tungkaG/micromouse/Bill_of_Materials.xls

MICRO MOUSE
Mouser-Nr. | Herst.- Nr. | Hersteller | Kunden-Teilenr | Beschreibung | RoHS | Lebenszyklus | Stückzahl | Preis (EUR) | Gesamtpreis: (EUR)
579-DSPIC364MC804IML | DSPIC33FJ64MC804-I/ML | Microchip |  | Digitale Signalprozessoren und Controller - DSP, DSC 16B DSC 44LD64KB | RoHS-konform |  | 1 | 6,65 € | 6,65 €
852-GP2Y0A51SK0F | GP2Y0A51SK0F | Sharp Microelectronics |  | Entfernungssensor-Module - umschlossen | RoHS-konform |  | 3 | 5,78 € | 17,34 €
815-ABM8-20-B2-T | ABM8-20.000MHZ-B2-T | ABRACON |  | Quarze Xtal 3225 4-SMD 20MHz Tol A+/-20ppm Stab A+/-50ppm -20AC ~ 70AC 18pF 50 Ohms | RoHS-konform |  | 1 | 0,387 € | 0,39 €
757-TB6612FNGC8EL | TB6612FNG,C,8,EL | Toshiba |  | Motor / Bewegung / Zündungscontroller und Treiber Brush Motor Driver IC | RoHS-konform |  | 2 | 1,64 € | 3,28 €
520-HCU737-20X | ECS-73-20-4X | ECS |  | Quarze 7.3728MHz 20pF | RoHS-konform |  | 2 | 0,513 € | 1,03 €
653-B3F-1020 | B3F-1020 | Omron |  | Sensorschalter 6X6 Flat 5mm Btn Force 100g w/o Grd | RoHS-konform |  | 1 | 0,261 € | 0,26 €
859-LTST-C150KRKT | LTST-C150KRKT | LITEON |  | Einfarbige LEDs leds Red Clear 631nm | RoHS-konform |  | 1 | 0,234 € | 0,23 €
855-M20-8900605R | M20-8900605R | Harwin |  | Sockel & Kabelgehäuse 6 WAY SIL HORIZ SMT HDR T&R (600) | RoHS-konform |  | 1 | 1,33 € | 1,33 €
926-LM2937IMP5.0NOPB | LM2937IMP-5.0/NOPB | Texas Instruments |  | LDO Spannungs-Regulator 500 MA LDO REG A 926-LM2937IMPX50NOPB | RoHS-konform |  | 1 | 2,09 € | 2,09 €
