tungkaG/micromouse/Mouser Parts/0.1µF/C0805J104K1RACAUTO/3D/C0805J104K1RACAUTO.stp

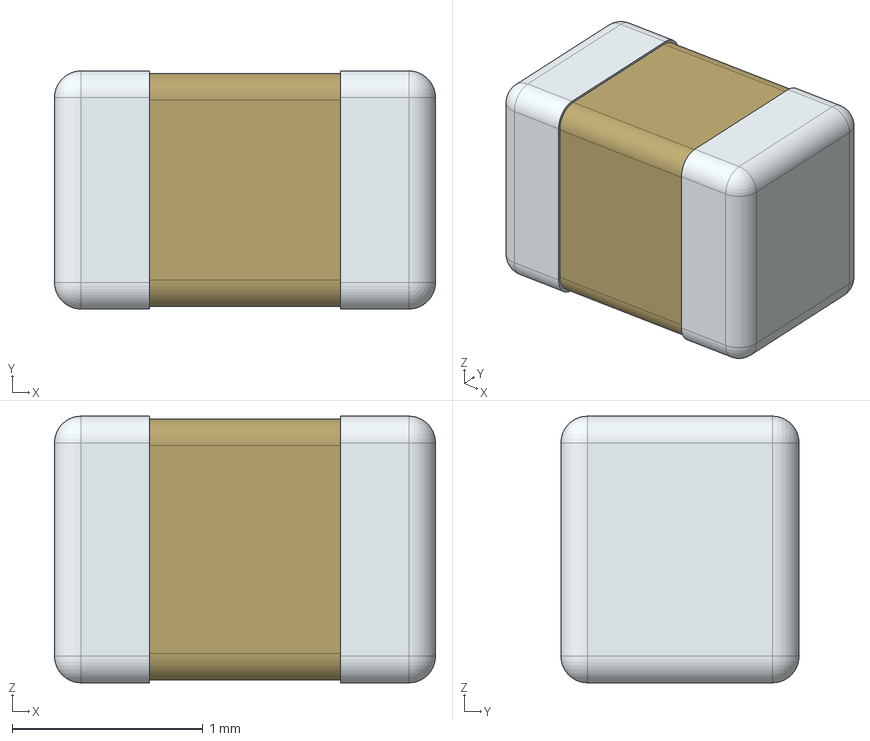
[picture p1: CAD file, 2025-08-03]
Mouser Parts/0.1µF/C0805J104K1RACAUTO/3D/C0805J104K1RACAUTO.stp
2.00 x 1.25 x 1.40 mm
