tungkaG/micromouse/Mouser Parts/10k Resistor/RNCE0805BTE10K0/3D/RNCE0805BTE10K0.stp

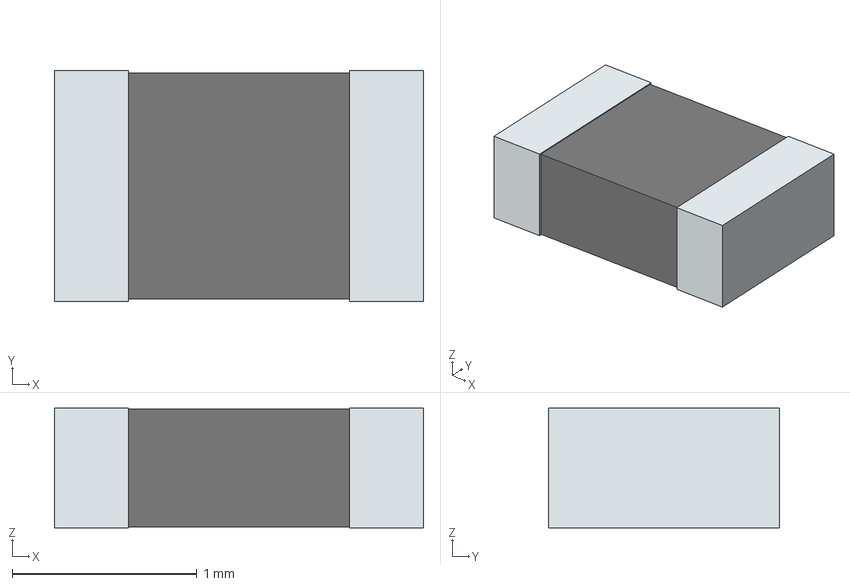
[picture p2: CAD file, 2025-08-04]
Mouser Parts/10k Resistor/RNCE0805BTE10K0/3D/RNCE0805BTE10K0.stp
2.00 x 1.25 x 0.65 mm
term1
term2
