tungkaG/micromouse/Mouser Parts/10µF Capacitor/0805YC106KAT2A/3D/0805YC106KAT2A.stp

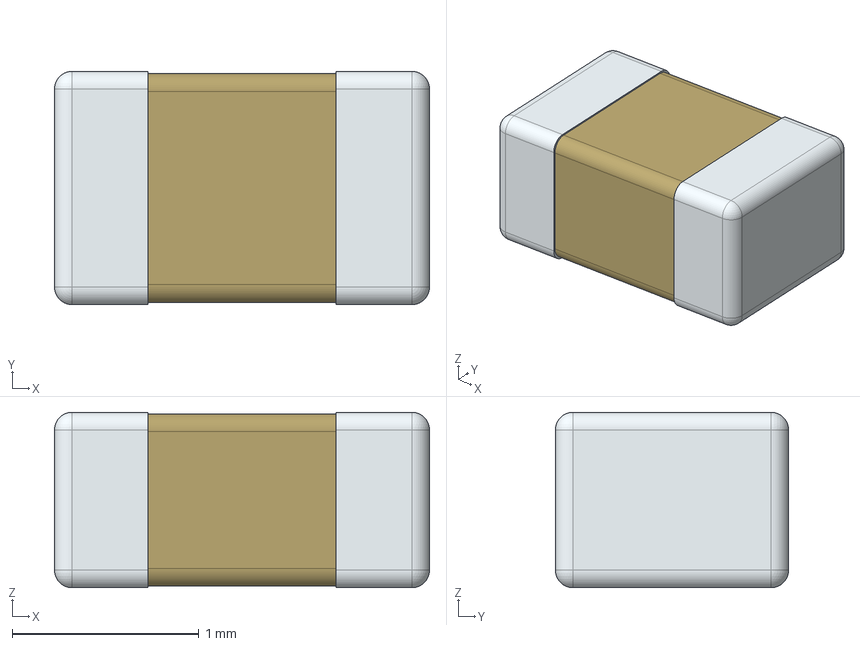
[picture p3: CAD file, 2025-08-03]
Mouser Parts/10µF Capacitor/0805YC106KAT2A/3D/0805YC106KAT2A.stp
2.01 x 1.25 x 0.94 mm
