tungkaG/micromouse/Mouser Parts/4.7k Resistor/ERA-6ARW472V/3D/ERA-6ARW472V.stp

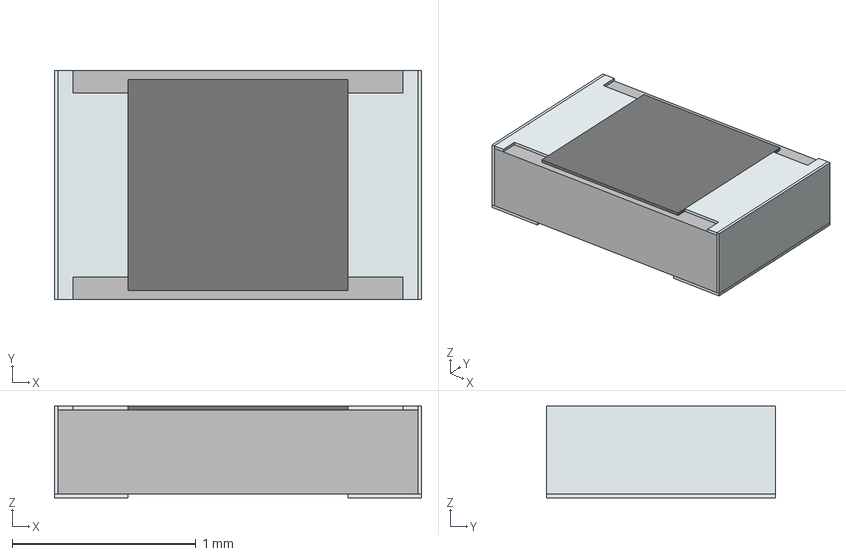
[picture p4: CAD file, 2025-08-03]
Mouser Parts/4.7k Resistor/ERA-6ARW472V/3D/ERA-6ARW472V.stp
2.00 x 1.25 x 0.5 mm
solidBody
solidTop
solidTerminal1
solidTerminal2
solidTerminal3
