tungkaG/micromouse/Mouser Parts/4.7µF/MBAST21GBC7475KTCA01/3D/MBAST21GBC7475KTCA01.stp

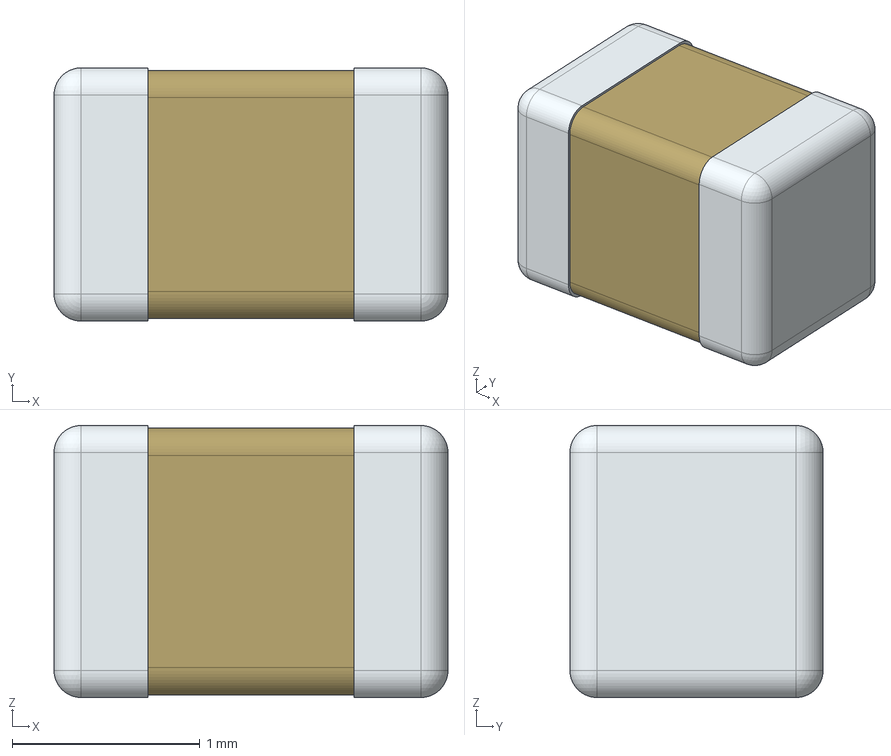
[picture p5: CAD file, 2025-08-04]
Mouser Parts/4.7µF/MBAST21GBC7475KTCA01/3D/MBAST21GBC7475KTCA01.stp
2.10 x 1.35 x 1.45 mm
