tungkaG/micromouse/Mouser Parts/Bluetooth/RN4871-I_RM130/3D/RN4871-I_RM130.stp

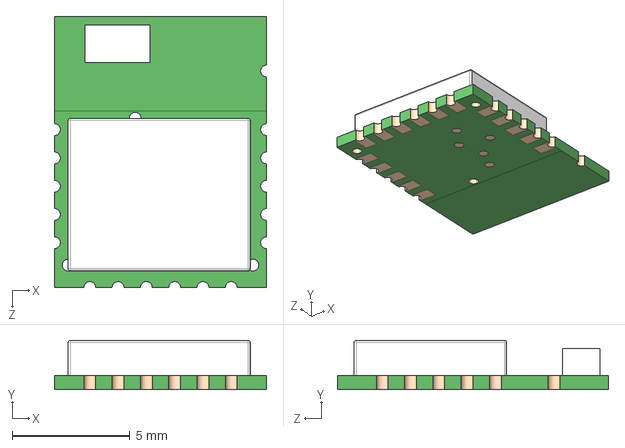
[picture p6: CAD file, 2025-07-26]
Mouser Parts/Bluetooth/RN4871-I_RM130/3D/RN4871-I_RM130.stp
9.00 x 2.10 x 11.5 mm
