tungkaG/micromouse/Mouser Parts/Chip/LIB_dsPIC33FJ64MC804-I_ML/dsPIC33FJ64MC804-I_ML/3D/dsPIC33FJ64MC804-I_ML.stp

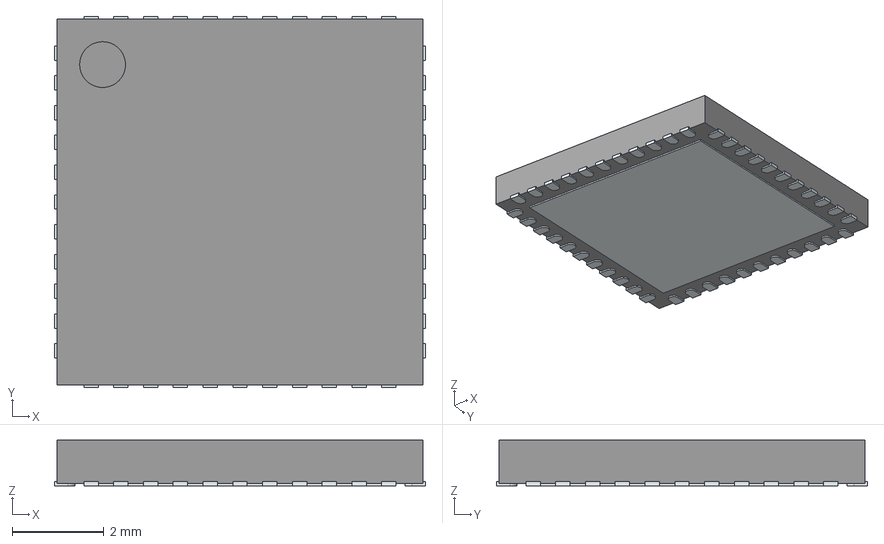
[picture p7: CAD file, 2025-07-16]
Mouser Parts/Chip/LIB_dsPIC33FJ64MC804-I_ML/dsPIC33FJ64MC804-I_ML/3D/dsPIC33FJ64MC804-I_ML.stp
8.10 x 8.10 x 1.00 mm
ThermalPin
PinsArrayLR
PinsArrayTB
