tungkaG/micromouse/Mouser Parts/Diode/1N4148WS-HG3-08/3D/1N4148WS-HG3-08.stp

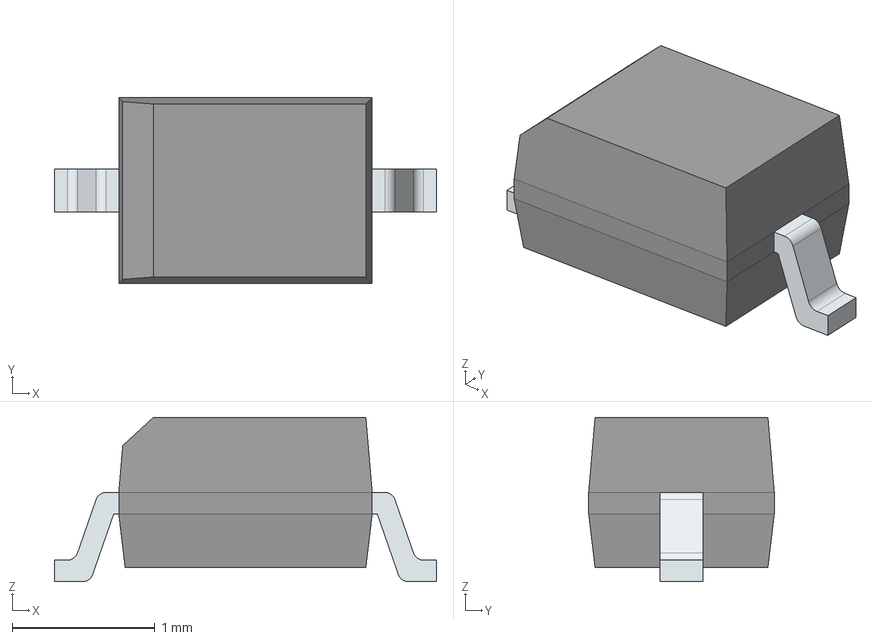
[picture p8: CAD file, 2025-08-03]
Mouser Parts/Diode/1N4148WS-HG3-08/3D/1N4148WS-HG3-08.stp
2.67 x 1.30 x 1.15 mm
FilletPinL
FilletPinR
