tungkaG/micromouse/Mouser Parts/H-Bridge/TB6612FNG,C,8,EL/3D/TB6612FNG,C,8,EL.stp

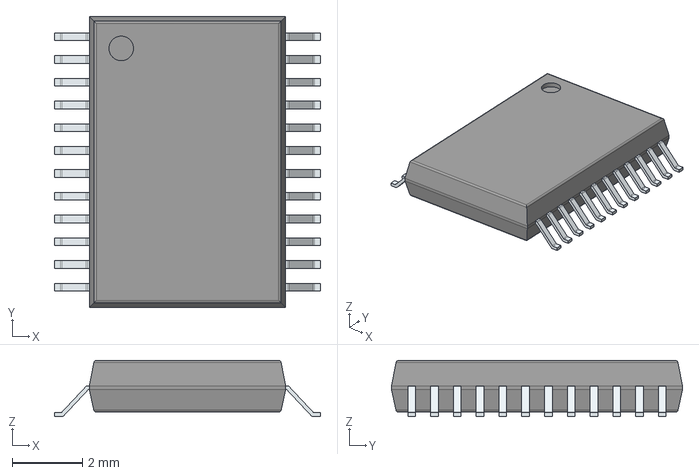
[picture p9: CAD file, 2025-07-20]
Mouser Parts/H-Bridge/TB6612FNG,C,8,EL/3D/TB6612FNG,C,8,EL.stp
7.60 x 8.30 x 1.60 mm
PinsArrayLR
