tungkaG/micromouse/Mouser Parts/Linear Regulator 3.3V/UA78M33CDCYG3/3D/UA78M33CDCYG3.stp

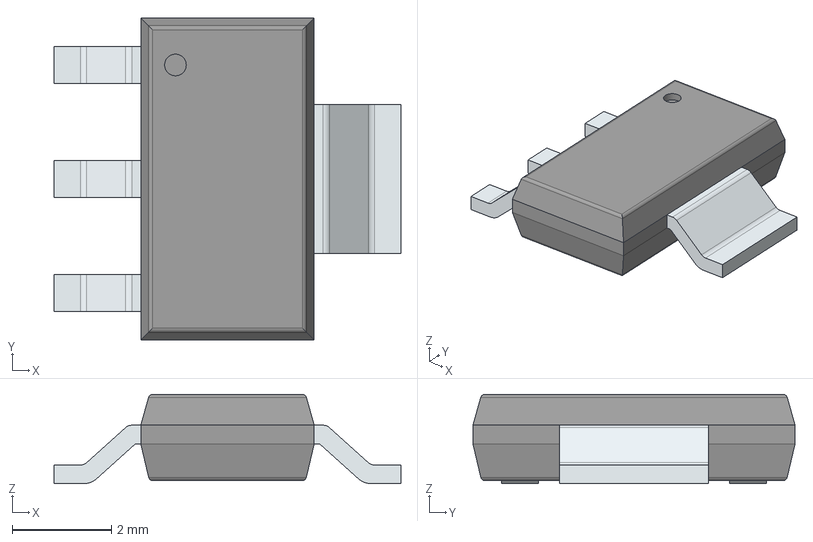
[picture p10: CAD file, 2025-07-19]
Mouser Parts/Linear Regulator 3.3V/UA78M33CDCYG3/3D/UA78M33CDCYG3.stp
7.00 x 6.50 x 1.80 mm
PinsArrayL
FilletPinR
