tungkaG/micromouse/Mouser Parts/Osc/ABM8-20.000MHZ-B2-T/3D/ABM8-20.000MHZ-B2-T.stp

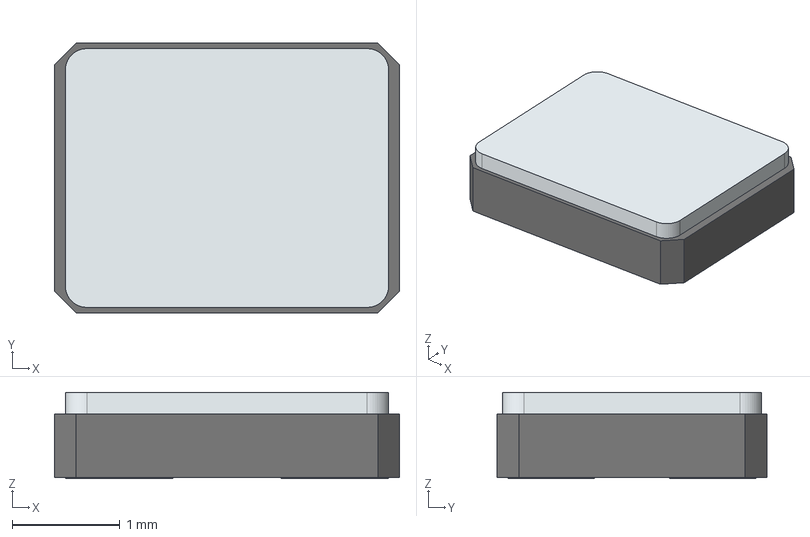
[picture p11: CAD file, 2025-07-21]
Mouser Parts/Osc/ABM8-20.000MHZ-B2-T/3D/ABM8-20.000MHZ-B2-T.stp
3.20 x 2.50 x 0.8 mm
solidBody
solidLid
solidTerminal
