tungkaG/micromouse/Mouser Parts/Switch/B3F-1020/3D/B3F-1020.stp

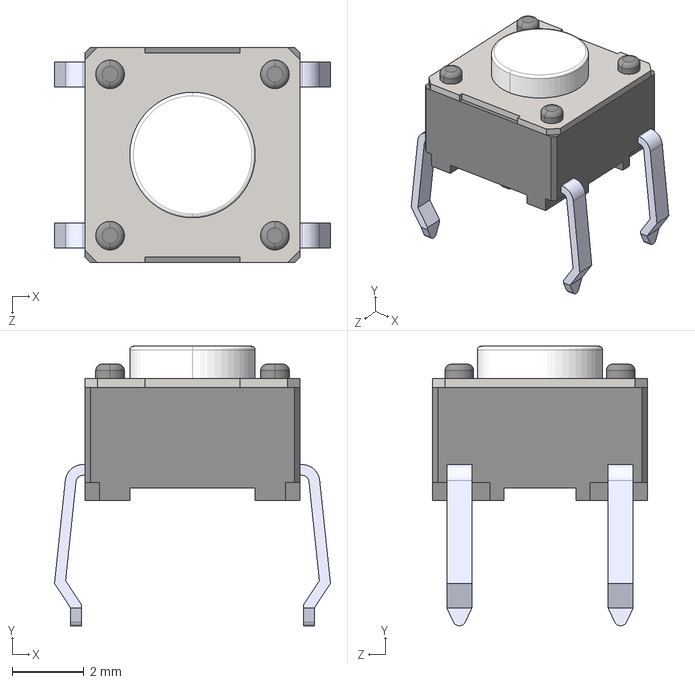
[picture p12: CAD file, 2025-08-03]
Mouser Parts/Switch/B3F-1020/3D/B3F-1020.stp
7.70 x 7.80 x 6.00 mm
