tungkaG/micromouse/Mouser Parts/0.33µF/08053C334KAZ2A/3D/08053C334KAZ2A.stp

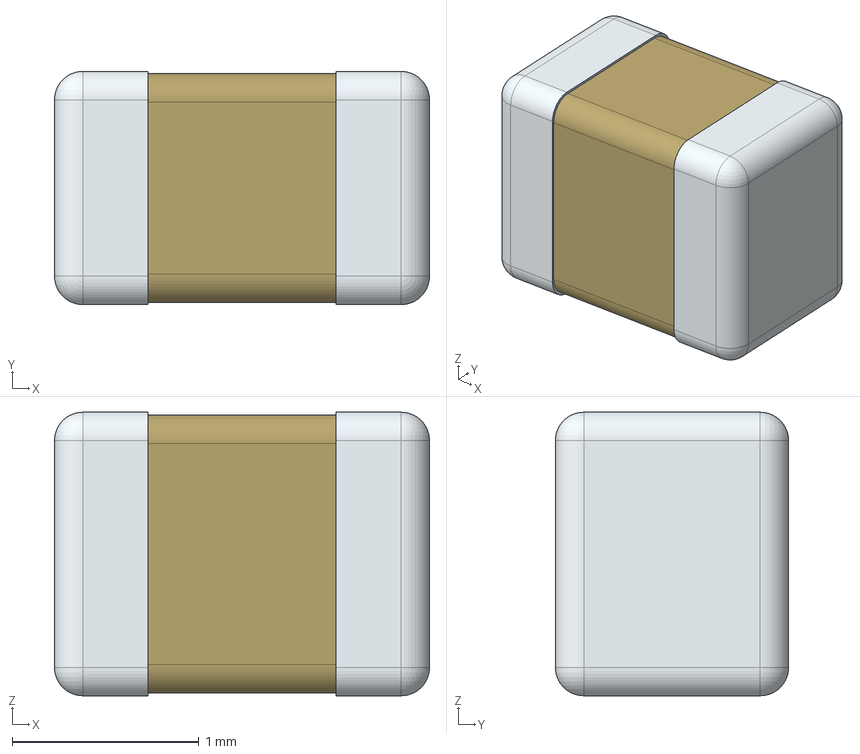
[picture p13: CAD file, 2025-08-03]
Mouser Parts/0.33µF/08053C334KAZ2A/3D/08053C334KAZ2A.stp
2.01 x 1.25 x 1.52 mm
