tungkaG/micromouse/Mouser Parts/MotorPinout/1761681-1/3D/1761681-1.stp

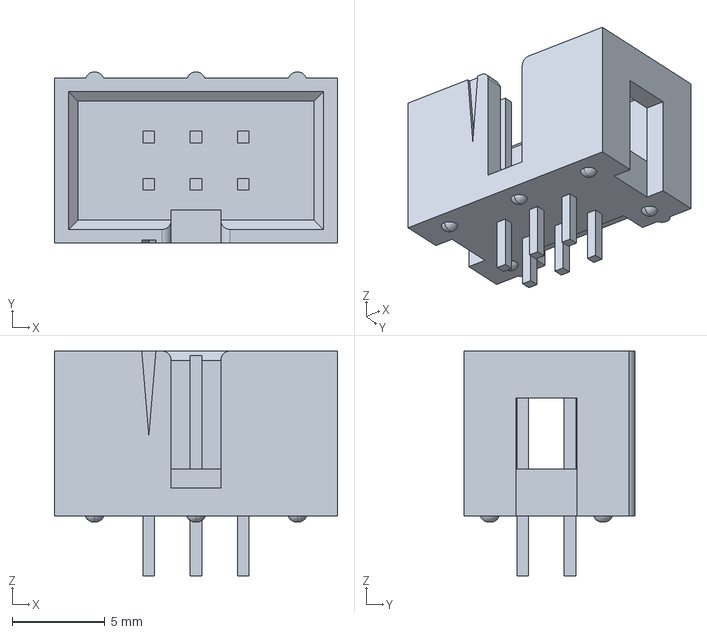
[picture p14: CAD file, 2025-07-15]
Mouser Parts/MotorPinout/1761681-1/3D/1761681-1.stp
15.2 x 9.22 x 12.1 mm
