tungkaG/micromouse/Mouser Parts/Terminal Block/691137710002/3D/691137710002.stp

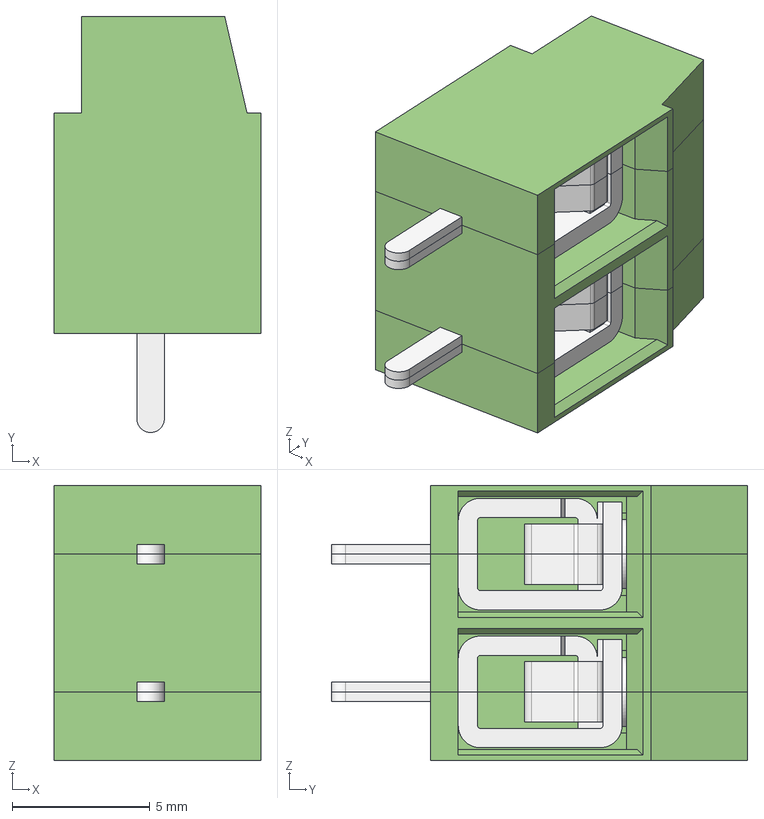
[picture p15: CAD file, 2025-08-05]
Mouser Parts/Terminal Block/691137710002/3D/691137710002.stp
7.50 x 15.1 x 10.0 mm
MRT12P5_SX
MRT12P5_CNT
MRT12P5_DX
