tungkaG/micromouse/(list of files, cad)

Other CAD files:
Mouser Parts/30pF/08055A300JAT2A/3D/08055A300JAT2A.stp
Mouser Parts/0.1µF/C0805J104K1RACAUTO/Allegro/capc2012x140n.psm
Mouser Parts/0.1µF/C0805J104K1RACAUTO/DEHDL/c0805j104k1racauto/chips/chips.prt
Mouser Parts/0.33µF/08053C334KAZ2A/Allegro/capc2012x152n.psm
Mouser Parts/0.33µF/08053C334KAZ2A/DEHDL/08053c334kaz2a/chips/chips.prt
Mouser Parts/10k Resistor/RNCE0805BTE10K0/Allegro/resc2012x65n.psm
Mouser Parts/10k Resistor/RNCE0805BTE10K0/DEHDL/rnce0805bte10k0/chips/chips.prt
Mouser Parts/10µF Capacitor/0805YC106KAT2A/Allegro/capc2012x94n.psm
Mouser Parts/10µF Capacitor/0805YC106KAT2A/DEHDL/0805yc106kat2a/chips/chips.prt
Mouser Parts/1µF Capacitor/C0805J104K1RACAUTO/Allegro/capc2012x140n.psm
Mouser Parts/1µF Capacitor/C0805J104K1RACAUTO/DEHDL/c0805j104k1racauto/chips/chips.prt
Mouser Parts/30pF/08055A300JAT2A/Allegro/capc2012x94n.psm
Mouser Parts/30pF/08055A300JAT2A/DEHDL/08055a300jat2a/chips/chips.prt
Mouser Parts/4.7k Resistor/ERA-6ARW472V/Allegro/era6aeb101v.psm
Mouser Parts/4.7k Resistor/ERA-6ARW472V/DEHDL/era_6arw472v/chips/chips.prt
Mouser Parts/4.7µF/MBAST21GBC7475KTCA01/Allegro/capc2114x145n.psm
Mouser Parts/4.7µF/MBAST21GBC7475KTCA01/DEHDL/mbast21gbc7475ktca01/chips/chips.prt
Mouser Parts/47k Resistor/ERA-6ARW473V/Allegro/era6aeb101v.psm
Mouser Parts/47k Resistor/ERA-6ARW473V/DEHDL/era_6arw473v/chips/chips.prt
Mouser Parts/Bluetooth/RN4871-I_RM130/Allegro/rn4871.psm
Mouser Parts/Bluetooth/RN4871-I_RM130/DEHDL/rn4871_i_rm130/chips/chips.prt
Mouser Parts/Chip/LIB_dsPIC33FJ64MC804-I_ML/dsPIC33FJ64MC804-I_ML/Allegro/qfn65p800x800x100-45n-d.psm
Mouser Parts/Chip/LIB_dsPIC33FJ64MC804-I_ML/dsPIC33FJ64MC804-I_ML/DEHDL/dspic33fj64mc804_i_ml/chips/chips.prt
Mouser Parts/Diode/1N4148WS-HG3-08/Allegro/sod2713x115n.psm
Mouser Parts/Diode/1N4148WS-HG3-08/DEHDL/1n4148ws_hg3_08/chips/chips.prt
Mouser Parts/H-Bridge/TB6612FNG,C,8,EL/Allegro/sop65p760x160-24n.psm
Mouser Parts/H-Bridge/TB6612FNG,C,8,EL/DEHDL/tb6612fng_c_8_el/chips/chips.prt
Mouser Parts/Led/APT3216LSECK_J3-PRV/Allegro/ledc3216x95n.psm
Mouser Parts/Led/APT3216LSECK_J3-PRV/DEHDL/apt3216lseck_j3_prv/chips/chips.prt
Mouser Parts/Linear Regulator 3.3V/UA78M33CDCYG3/Allegro/sot230p700x180-4n.psm
Mouser Parts/Linear Regulator 3.3V/UA78M33CDCYG3/DEHDL/ua78m33cdcyg3/chips/chips.prt
Mouser Parts/Linear Regulator 5V/ADP3338AKCZ-5-R7/Allegro/sot230p700x180-4n.psm
Mouser Parts/Linear Regulator 5V/ADP3338AKCZ-5-R7/DEHDL/adp3338akcz_5_r7/chips/chips.prt
Mouser Parts/MotorPinout/1761681-1/Allegro/shdr6w67p254_2x3_1524x916x922p.psm
Mouser Parts/MotorPinout/1761681-1/DEHDL/1761681_1/chips/chips.prt
Mouser Parts/Osc/ABM8-20.000MHZ-B2-T/Allegro/abm810000mhz12d2w.psm
Mouser Parts/Osc/ABM8-20.000MHZ-B2-T/DEHDL/abm8_20.000mhz_b2_t/chips/chips.prt
Mouser Parts/Switch/B3F-1020/Allegro/b3f1000.psm
Mouser Parts/Switch/B3F-1020/DEHDL/b3f_1020/chips/chips.prt
Mouser Parts/Terminal Block/691137710002/Allegro/shdr2w70p0x500_1x2_1000x750x1160p.psm
Mouser Parts/Terminal Block/691137710002/DEHDL/691137710002/chips/chips.prt
