tungkaG/micromouse/(list of files, drawings)

Other design files:
Mouser Parts/0.1µF/C0805J104K1RACAUTO/Altium/C0805J104K1RACAUTO.SchLib
Mouser Parts/0.1µF/C0805J104K1RACAUTO/Altium/CAPC2012X140N.PcbLib
Mouser Parts/0.33µF/08053C334KAZ2A/Altium/08053C334KAZ2A.SchLib
Mouser Parts/0.33µF/08053C334KAZ2A/Altium/CAPC2012X152N.PcbLib
Mouser Parts/1µF Capacitor/C0805J104K1RACAUTO/Altium/C0805J104K1RACAUTO.SchLib
Mouser Parts/1µF Capacitor/C0805J104K1RACAUTO/Altium/CAPC2012X140N.PcbLib
Mouser Parts/4.7k Resistor/ERA-6ARW472V/Altium/ERA6AEB101V.PcbLib
Mouser Parts/4.7k Resistor/ERA-6ARW472V/Altium/ERA-6ARW472V.SchLib
Mouser Parts/4.7µF/MBAST21GBC7475KTCA01/Altium/CAPC2114X145N.PcbLib
Mouser Parts/4.7µF/MBAST21GBC7475KTCA01/Altium/MBAST21GBC7475KTCA01.SchLib
Mouser Parts/10k Resistor/RNCE0805BTE10K0/Altium/RESC2012X65N.PcbLib
Mouser Parts/10k Resistor/RNCE0805BTE10K0/Altium/RNCE0805BTE10K0.SchLib
Mouser Parts/10µF Capacitor/0805YC106KAT2A/Altium/0805YC106KAT2A.SchLib
Mouser Parts/10µF Capacitor/0805YC106KAT2A/Altium/CAPC2012X94N.PcbLib
Mouser Parts/30pF/08055A300JAT2A/Altium/08055A300JAT2A.SchLib
Mouser Parts/30pF/08055A300JAT2A/Altium/CAPC2012X94N.PcbLib
Mouser Parts/47k Resistor/ERA-6ARW473V/Altium/ERA6AEB101V.PcbLib
Mouser Parts/47k Resistor/ERA-6ARW473V/Altium/ERA-6ARW473V.SchLib
Mouser Parts/Chip/LIB_dsPIC33FJ64MC804-I_ML/dsPIC33FJ64MC804-I_ML/Altium/dsPIC33FJ64MC804-I_ML.SchLib
Mouser Parts/Chip/LIB_dsPIC33FJ64MC804-I_ML/dsPIC33FJ64MC804-I_ML/Altium/QFN65P800X800X100-45N-D.PcbLib
Mouser Parts/Diode/1N4148WS-HG3-08/Altium/1N4148WS-HG3-08.SchLib
Mouser Parts/Diode/1N4148WS-HG3-08/Altium/SOD2713X115N.PcbLib
Mouser Parts/H-Bridge/TB6612FNG,C,8,EL/Altium/SOP65P760X160-24N.PcbLib
Mouser Parts/H-Bridge/TB6612FNG,C,8,EL/Altium/TB6612FNG_C_8_EL.SchLib
Mouser Parts/Led/APT3216LSECK_J3-PRV/Altium/APT3216LSECK_J3-PRV.SchLib
Mouser Parts/Led/APT3216LSECK_J3-PRV/Altium/LEDC3216X95N.PcbLib
Mouser Parts/Linear Regulator 3.3V/UA78M33CDCYG3/Altium/SOT230P700X180-4N.PcbLib
Mouser Parts/Linear Regulator 3.3V/UA78M33CDCYG3/Altium/UA78M33CDCYG3.SchLib
Mouser Parts/MotorPinout/1761681-1/Altium/1761681-1.SchLib
Mouser Parts/MotorPinout/1761681-1/Altium/SHDR6W67P254_2X3_1524X916X922P.PcbLib
Mouser Parts/Terminal Block/691137710002/Altium/691137710002.SchLib
Mouser Parts/Terminal Block/691137710002/Altium/SHDR2W70P0X500_1X2_1000X750X1160P.PcbLib
