tungkaG/micromouse/project.brd

## EAGLE design project.brd (2025-08-05)

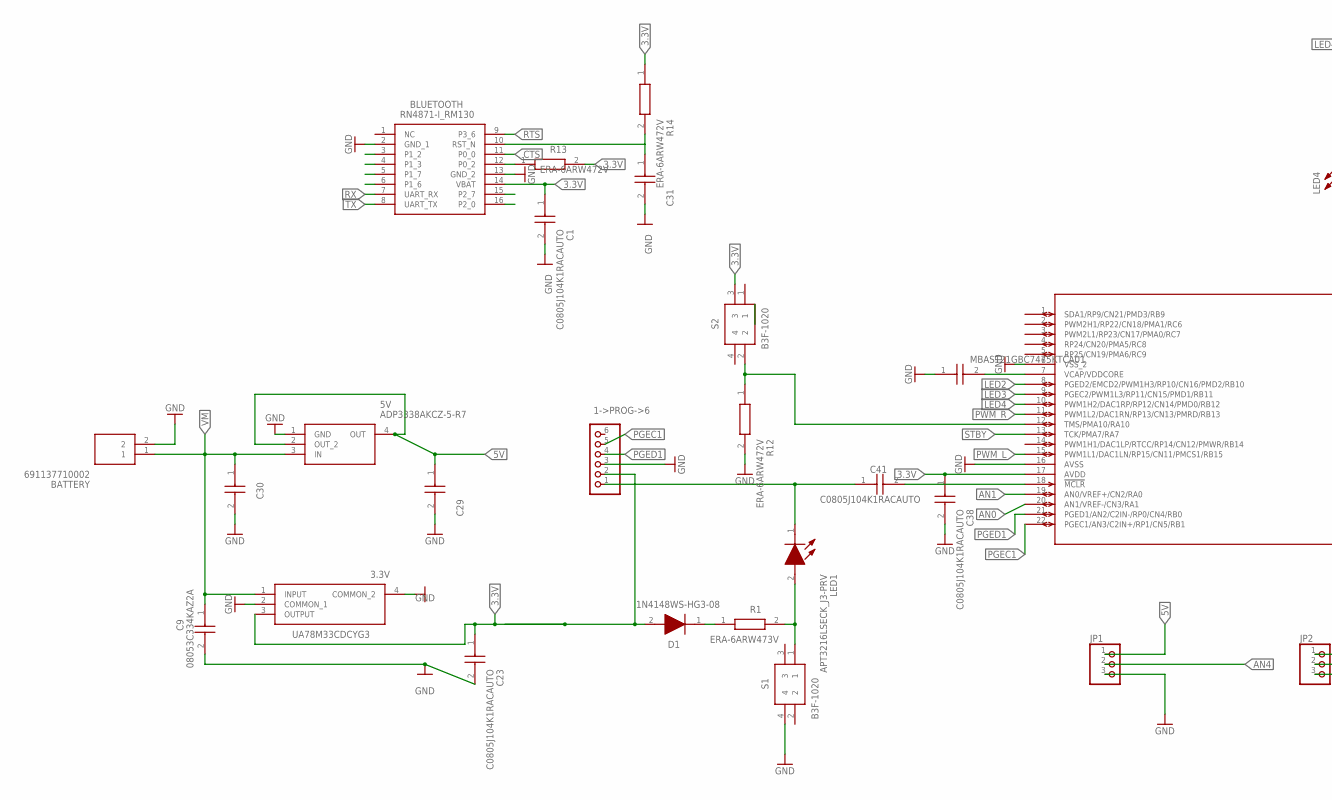
[picture p16: schematic project.sch, part in row 1, column 1]

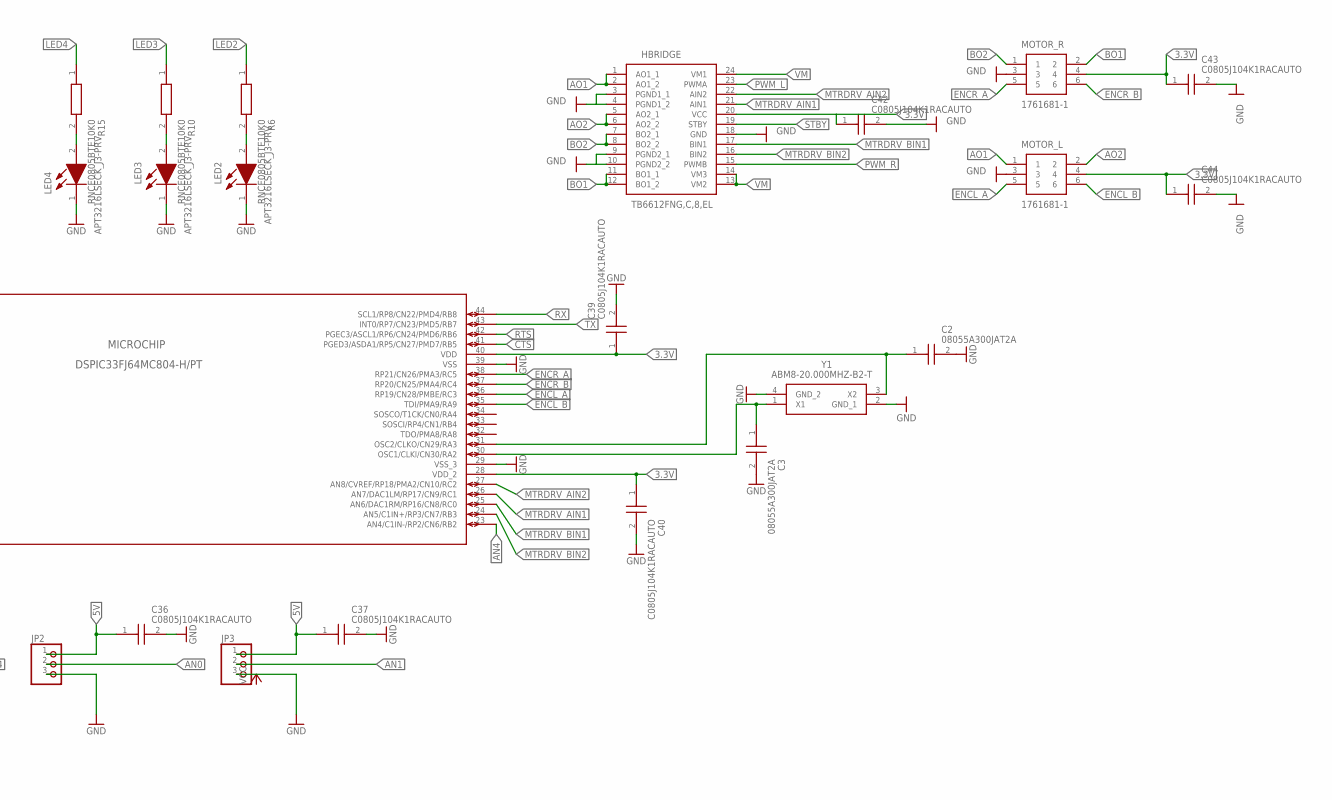
[picture p17: schematic project.sch, part in row 1, column 2]

Parts:
1->PROG->6: PINHD-1X6; 1X06
3.3V: UA78M33CDCYG3; SOT230P700X180-4N
5V: ADP3338AKCZ-5-R7; SOT230P700X180-4N
BATTERY: 691137710002; SHDR2W70P0X500_1X2_1000X750X11
BLUETOOTH: RN4871-I_RM130; RN4871
C1, C23, C29, C31, C36, C37, C38, C39, C40, C41, C42, C43, C44: C0805J104K1RACAUTO; CAPC2012X140N
C2, C3: 08055A300JAT2A; CAPC2012X94N
C4: MBAST21GBC7475KTCA01; CAPC2114X145N
C9: 08053C334KAZ2A; CAPC2012X152N
C30: 1µF; CAPC2012X140N
D1: 1N4148WS-HG3-08; SOD2713X115N
HBRIDGE: TB6612FNG,C,8,EL; SOP65P760X160-24N
JP1, JP2, JP3: PINHD-1X3; 1X03
LED1, LED2, LED3, LED4: APT3216LSECK_J3-PRV; LEDC3216X95N
MICROCHIP: DSPIC33FJ64MC804-H/PT; TQFP44_10X10MC_MCH
MOTOR_L: 1761681-1; SHDR6W67P254_2X3_1524X916X922P
MOTOR_R: 1761681-1; SHDR6W67P254_2X3_1524X916X922P
R1: ERA-6ARW473V; ERA6AEB101V
R6, R10, R15: RNCE0805BTE10K0; RESC2012X65N
R12, R13, R14: ERA-6ARW472V; ERA6AEB101V
S1, S2: B3F-1020; B3F1000
Y1: ABM8-20.000MHZ-B2-T; ABM810000MHZ12D2W

Connections:
3.3V: 1->PROG->6.2, 3.3V.3 (OUTPUT), BLUETOOTH.14 (VBAT), C1.1, C23.1, C38.1, C39.1, C40.1, C42.1, C43.1, C44.1, D1.2 (A), HBRIDGE.20 (VCC), MICROCHIP.17 (AVDD), MICROCHIP.28 (VDD_2), MICROCHIP.40 (VDD), MOTOR_L.4, MOTOR_R.4, R13.2, R14.1, S2.3
5V: 5V.2 (OUT_2), 5V.4 (OUT), C29.1, C36.1, C37.1, JP1.1, JP2.1, JP3.1
AN0: JP2.2, MICROCHIP.20 (AN1/VREF-/CN3/RA1)
AN1: JP3.2, MICROCHIP.19 (AN0/VREF+/CN2/RA0)
AN4: JP1.2, MICROCHIP.23 (AN4/C1IN-/RP2/CN6/RB2)
AO1: HBRIDGE.1 (AO1_1), HBRIDGE.2 (AO1_2), MOTOR_L.1
AO2: HBRIDGE.5 (AO2_1), HBRIDGE.6 (AO2_2), MOTOR_L.2
BO1: HBRIDGE.11 (BO1_1), HBRIDGE.12 (BO1_2), MOTOR_R.2
BO2: HBRIDGE.7 (BO2_1), HBRIDGE.8 (BO2_2), MOTOR_R.1
CTS: BLUETOOTH.11 (P0_0), MICROCHIP.41 (PGED3/ASDA1/RP5/CN27/PMD7/RB5)
ENCL_A: MICROCHIP.36 (RP19/CN28/PMBE/RC3), MOTOR_L.5
ENCL_B: MICROCHIP.35 (TDI/PMA9/RA9), MOTOR_L.6
ENCR_A: MICROCHIP.38 (RP21/CN26/PMA3/RC5), MOTOR_R.5
ENCR_B: MICROCHIP.37 (RP20/CN25/PMA4/RC4), MOTOR_R.6
GND: 1->PROG->6.3, 3.3V.2 (COMMON_1), 3.3V.4 (COMMON_2), 5V.1 (GND), BATTERY.2, BLUETOOTH.2 (GND_1), BLUETOOTH.13 (GND_2), C1.2, C2.2, C3.2, C4.1, C9.2, C23.2, C29.2, C30.2, C31.2, C36.2, C37.2, C38.2, C39.2, C40.2, C42.2, C43.2, C44.2, HBRIDGE.3 (PGND1_1), HBRIDGE.4 (PGND1_2), HBRIDGE.9 (PGND2_1), HBRIDGE.10 (PGND2_2), HBRIDGE.18 (GND), JP1.3, JP2.3, JP3.3, LED2.1 (K), LED3.1 (K), LED4.1 (K), MICROCHIP.6 (VSS_2), MICROCHIP.16 (AVSS), MICROCHIP.29 (VSS_3), MICROCHIP.39 (VSS), MOTOR_L.3, MOTOR_R.3, R12.2, S1.4, Y1.2 (GND_1), Y1.4 (GND_2)
LED2: MICROCHIP.8 (PGED2/EMCD2/PWM1H3/RP10/CN16/PMD2/RB10), R6.1
LED3: MICROCHIP.9 (PGEC2/PWM1L3/RP11/CN15/PMD1/RB11), R10.1
LED4: MICROCHIP.10 (PWM1H2/DAC1RP/RP12/CN14/PMD0/RB12), R15.1
MTRDRV_AIN1: HBRIDGE.21 (AIN1), MICROCHIP.26 (AN7/DAC1LM/RP17/CN9/RC1)
MTRDRV_AIN2: HBRIDGE.22 (AIN2), MICROCHIP.27 (AN8/CVREF/RP18/PMA2/CN10/RC2)
MTRDRV_BIN1: HBRIDGE.17 (BIN1), MICROCHIP.25 (AN6/DAC1RM/RP16/CN8/RC0)
MTRDRV_BIN2: HBRIDGE.16 (BIN2), MICROCHIP.24 (AN5/C1IN+/RP3/CN7/RB3)
unnamed: C2.1, MICROCHIP.31 (OSC2/CLKO/CN29/RA3), Y1.3 (X2)
unnamed: C3.1, MICROCHIP.30 (OSC1/CLKI/CN30/RA2), Y1.1 (X1)
unnamed: D1.1 (K), R1.1
unnamed: LED4.2 (A), R15.2
unnamed: C4.2, MICROCHIP.7 (VCAP/VDDCORE)
unnamed: 1->PROG->6.1, C41.1, LED1.1 (K)
unnamed: LED3.2 (A), R10.2
unnamed: LED2.2 (A), R6.2
unnamed: LED1.2 (A), R1.2, S1.1
unnamed: C41.2, MICROCHIP.18 (!MCLR)
unnamed: MICROCHIP.12 (TMS/PMA10/RA10), R12.1, S2.2
unnamed: BLUETOOTH.10 (RST_N), C31.1, R14.2
unnamed: BLUETOOTH.12 (P0_2), R13.1
PGEC1: 1->PROG->6.5, MICROCHIP.22 (PGEC1/AN3/C2IN+/RP1/CN5/RB1)
PGED1: 1->PROG->6.4, MICROCHIP.21 (PGED1/AN2/C2IN-/RP0/CN4/RB0)
PWM_L: HBRIDGE.23 (PWMA), MICROCHIP.15 (PWM1L1/DAC1LN/RP15/CN11/PMCS1/RB15)
PWM_R: HBRIDGE.15 (PWMB), MICROCHIP.11 (PWM1L2/DAC1RN/RP13/CN13/PMRD/RB13)
RTS: BLUETOOTH.9 (P3_6), MICROCHIP.42 (PGEC3/ASCL1/RP6/CN24/PMD6/RB6)
RX: BLUETOOTH.7 (UART_RX), MICROCHIP.44 (SCL1/RP8/CN22/PMD4/RB8)
STBY: HBRIDGE.19 (STBY), MICROCHIP.13 (TCK/PMA7/RA7)
TX: BLUETOOTH.8 (UART_TX), MICROCHIP.43 (INT0/RP7/CN23/PMD5/RB7)
VM: 3.3V.1 (INPUT), 5V.3 (IN), BATTERY.1, C9.1, C30.1, HBRIDGE.13 (VM2), HBRIDGE.14 (VM3), HBRIDGE.24 (VM1)

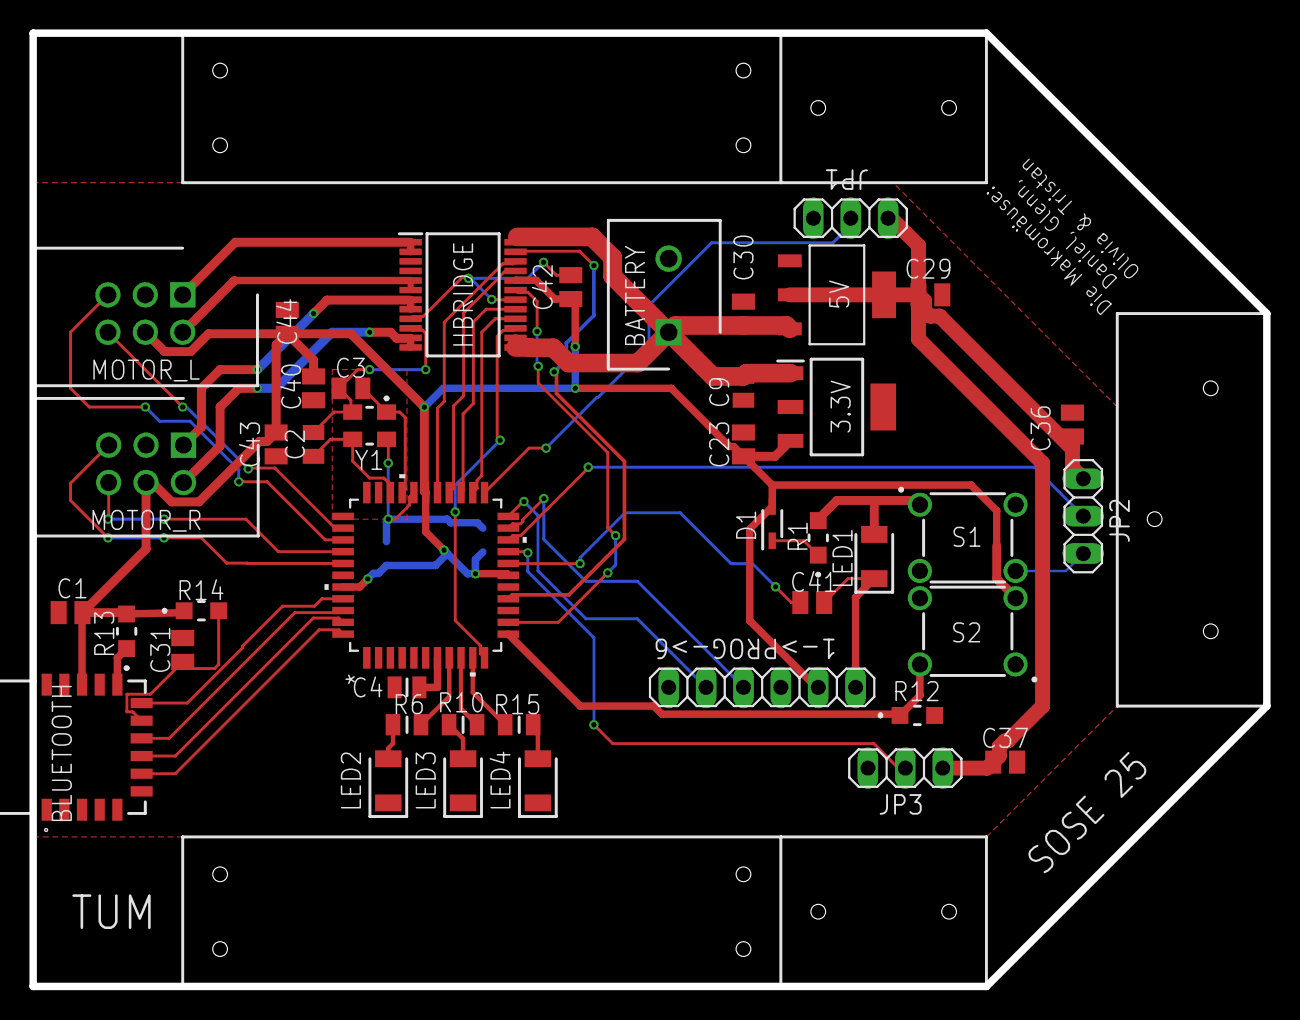
[picture p18: board project.brd from above]

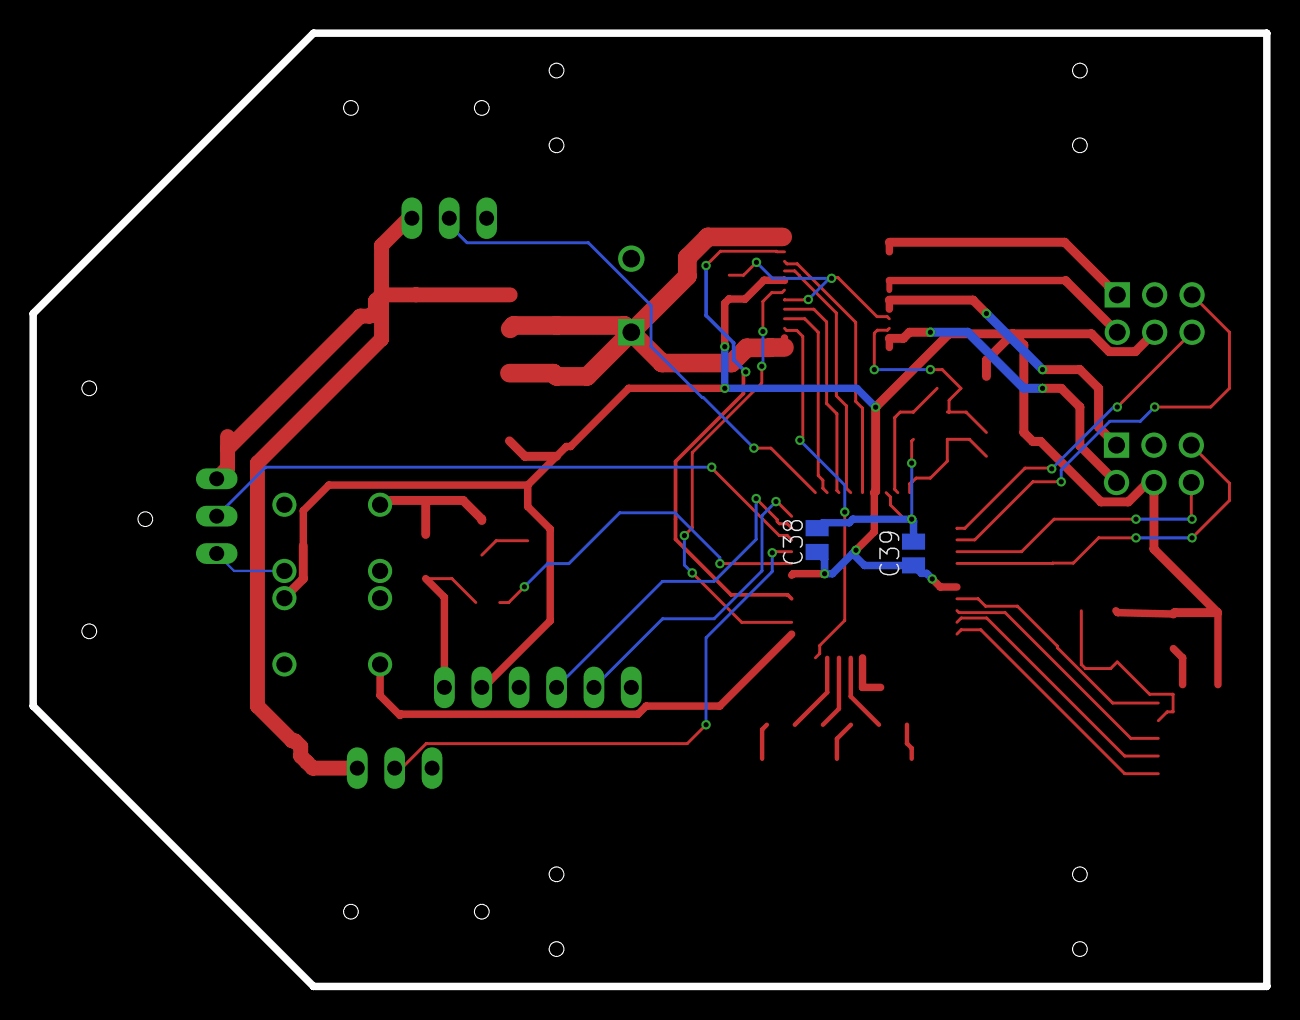
[picture p19: board project.brd from below]

Board: 2 copper layers, 83.8 x 64.8 mm, 45 parts (2 on the bottom side), 44 nets.
