tungkaG/micromouse/(threads)

Thread 1 (2025-07-06):

Find out Motor speed constant

tungkaG, 2025-07-06:
We must find out the constant k_m where motor speed = k_m x voltage (from PWM duty cycle).
This constant is also dependant on the battery's current state but lets assume its always 7.4V
We can find this constant by setting 5 -10 different pwm values and read out the speed. Then a linear regression can be done

Daniel-Marth, 2025-07-29:
We tested the motors to have a velocity of ~18 rad/s when applying 100% pwm at 6 Volt (max. voltage for motors afaik). But I dont know if we need k_m exactly since the PI-Controller takes care of this: Takes the desired setpoint and the current measured motor velocity (both in rad/s) and returns the PWM (in %) which can then be directly applied to the motors (for details see PI_Update() in main.c in demo-mouse branch)

Thread 2 (2025-07-06):

Design motor PI controller

tungkaG, 2025-07-06:
After finding out the motor constant k_m, we need to ensure that the speed is always followed, even if our constant is not perfectly representing reality. Therefore a PI controller is needed. Here, it is important to ensure that it is updated at a constant frequency (place the function in a timer callback). 100 Hz is a good starting point, I think
