tungkaG/micromouse/(commit log)

2025-07-10 add external oscillator
    [project.sch]
2025-07-10 connect the other 2 sensors
    [project.sch]
2025-07-10 add motor driver
    [project.sch]
2025-07-10 add UAB_UART converter
    [project.sch]
2025-07-15 Motor Pinout
    [1761681-1.SchLib, 1761681-1.stp, EDI2CAP.CFG, SHDR6W67P254_2X3_1524X916X922P.PcbLib, chips.prt, shdr6w67p254_2x3_1524x916x922p.psm]
2025-07-15 Motor Pinout in Schematic
    [project.sch]
2025-07-15 add motor, leds, debug pins, replace USBUART with bluetooth ver.
    [project.sch]
2025-07-16 corrected led/lin regulator elements
    [APT3216LSECK_J3-PRV.SchLib, Bill_of_Materials.xls, EDI2CAP.CFG, LEDC3216X95N.PcbLib, LM2937IMPX-3.3_NOPB.SchLib, LM2937IMPX-3.3_NOPB.stp, QFN65P800X800X100-45N-D.PcbLib, SOT230P700X180-4N.PcbLib]
2025-07-18 Removed Liner Regulator
    [project.sch]
2025-07-19 Linear Regulator Added
    [EDI2CAP.CFG, LM2937IMPX-3.3_NOPB.SchLib, LM2937IMPX-3.3_NOPB.stp, SOT230P700X180-4N.PcbLib, UA78M33CDCYG3.SchLib, UA78M33CDCYG3.stp, chips.prt, project.sch]
2025-07-19 Renamed Components
    [project.sch]
2025-07-19 kleine Änderungen
    [EDI2CAP.CFG, SOT230P700X180-4N.PcbLib, UA78M33CDCYG3.SchLib, UA78M33CDCYG3.stp, chips.prt, project.sch, sot230p700x180-4n.psm]
2025-07-20 HBridge Verändert
    [EDI2CAP.CFG, SOP65P760X160-24N.PcbLib, TB6612FNG,C,8,EL.stp, TB6612FNG_C_8_EL.SchLib, chips.prt, sop65p760x160-24n.psm]
2025-07-22 Schematic Vollständig?
    [project.sch]
2025-07-22 Board Created
    [project.brd]
2025-07-22 All components placed
    [project.sch]
2025-07-22 rename ENCA and ENCB, remap PWM pins
    [project.sch]
2025-07-22 add 5V voltage regulator
    [project.sch]
2025-07-25 Leds added, 5v Regulator Moved, Bluetooth removed
    [project.sch]
2025-07-26 Small Changes
    [project.sch]
2025-07-26 Added Bluetooth Module
    [EDI2CAP.CFG, RN4871-I_RM130.stp, chips.prt, project.sch, rn4871.psm]
2025-07-27 group and place components in board
    [project.brd, project.sch]
2025-07-27 route board
    [project.brd, project.sch]
2025-08-04 Saving Progress
    [08055A300JAT2A.SchLib, 08055A300JAT2A.stp, CAPC2012X94N.PcbLib, EDI2CAP.CFG, capc2012x94n.psm, chips.prt, project.brd, project.sch]
2025-08-04 review #1
    [project.brd, project.sch]
