tungkaG/micromouse/(notices)

Notices in the files:
parts and their libraries:
DSPIC33FJ64MC804-H_PT: COPYRIGHT: Copyright (C) 2025 Ultra Librarian. All rights reserved.
